sunyata000/AMY_MCU/README_AMY.md

# 项目赞助
<br>
小额赞助、购买FPGA开发板、提供开发支持、甚至是一条建议或者评论，都是鼓舞PODES前行的动力。如果您有意赞助，请使用手机支付扫一扫下面的二维码：<br>
       
<center>
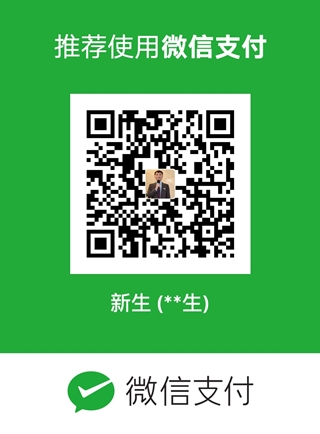
[picture p3: images/wechat.jpg]
    
    <div style="color:orange; border-bottom: 1px solid #d9d9d9;
    display: inline-block;
    color: #999;
    padding: 2px;">微信赞赏</div>
</center>
<br>
<center>
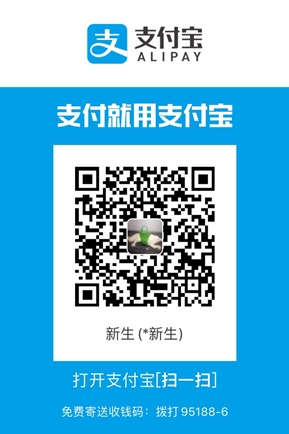
[picture p4: images/alipay.jpg]
    
    <div style="color:orange; border-bottom: 1px solid #d9d9d9;
    display: inline-block;
    color: #999;
    padding: 2px;">支付宝赞赏</div>
</center>
<br> 

[Back](https://github.com/sunyata000/AMY_MCU)
