sunyata000/AMY_MCU/sim/work/boot_test.txt

20000460
0000014D
00000155
00000157
00000000
00000000
00000000
00000000
00000000
00000000
00000000
00000159
00000000
00000000
0000015B
0000015D
0000015F
0000015F
0000015F
0000015F
0000015F
0000015F
0000015F
0000015F
0000015F
0000015F
0000015F
0000015F
0000015F
0000015F
0000015F
0000015F
0000015F
0000015F
0000015F
0000015F
0000015F
0000015F
0000015F
0000015F
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
46AB1E67
465D4654
D10142AC
F824F000
3E0F467E
46B6CC0F
42332601
1AFBD000
46AB46A2
47184333
000001C4
000001D4
24002300
26002500
D3013A10
D8FBC178
D3000752
D500C130
4770600B
46C0B51F
BD1F46C0
BD10B510
F89FF000
F7FF4611
F000FFF5
F000F844
B403F8B7
FFF2F7FF
F000BC03
0000F888
47804807
47004807
E7FEE7FE
E7FEE7FE
E7FEE7FE
49054804
4B064A05
00004770
00000265
000000C1
20000060
20000460
20000260
20000260
2101BF00
68490789
40112204
D0F80889
4917BF00
BF006008
4915BF00
22066849
29064011
4770D1F9
4603B500
7818E003
F7FF1C5B
7818FFE5
D1F82800
BF00BD00
490B2000
BF006048
2032BF00
BF0060C8
2003BF00
BF006088
2000BF00
BF006048
F7FFA004
207EFFE1
FFCAF7FF
E7FEBF00
40000000
594D415B
4F4F4220
203A5D54
2055434D
69207369
6F62206E
6D20746F
2E65646F
61655220
74207964
6572206F
76696563
68742065
6F632065
0A216564
00000000
4604B570
B2E5460E
F7FF4628
BD70FF9F
48054601
B5104770
B2E04604
FF96F7FF
BF00BD10
0000E7FE
FFFFFFFF
47704770
47704770
46754770
F822F000
000546AE
46534669
00C008C0
B0184685
F7FFB520
BC60FF6B
08492700
260046B6
C5C0C5C0
C5C0C5C0
C5C0C5C0
C5C0C5C0
00493D40
4770468D
46C04604
462046C0
FF43F7FF
47704800
20000000
00000300
20000000
00000460
00000104
00000000
00000000
00000000
00000000
00000000
00000000
00000000
00000000
00000000
00000000
00000000
FFFFFFFF
