sunyata000/AMY_MCU/sim/testcase/alu_test/alu_test.txt

200006C0
00000209
00000211
00000213
00000000
00000000
00000000
00000000
00000000
00000000
00000000
00000215
00000000
00000000
00000217
00000219
0000021B
0000021B
0000021B
0000021B
0000021B
0000021B
0000021B
0000021B
0000021B
0000021B
0000021B
0000021B
0000021B
0000021B
0000021B
0000021B
0000021B
0000021B
0000021B
0000021B
0000021B
0000021B
0000021B
0000021B
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
F83AF000
C830A00C
18243808
46A2182D
46AB1E67
465D4654
D10142AC
F82CF000
3E0F467E
46B6CC0F
42332601
1AFBD000
46AB46A2
47184333
00000970
00000990
24002300
26002500
D3013A10
D8FBC178
D3000752
D500C130
4770600B
2978B510
F000D102
BD10FAEF
BD102000
46C0B51F
BD1F46C0
BD10B510
FC2CF000
F7FF4611
F000FFF5
F000F8E5
B403FC44
FFF2F7FF
F000BC03
0000F812
4604B570
B2E5460E
F0004628
BD70F82B
48054601
B5104770
B2E04604
F822F000
BF00BD10
0000E7FE
FFFFFFFF
4604B570
26002503
481A00E1
FAEEF000
BF001E46
49182000
BF006088
6048BF00
BF00BF00
60C64608
2004BF00
BF004305
60854811
BD70BF00
490FBF00
22046849
08894011
BF00D0F9
6008490B
BF00BF00
68494909
40112206
D1F92906
B5004770
E0034603
1C5B7818
FFE6F7FF
28007818
BD00D1F8
02FAF080
40000000
00004770
47804807
47004807
E7FEE7FE
E7FEE7FE
E7FEE7FE
49054804
4B064A05
00004770
00000205
000000C1
200002C0
200006C0
200004C0
200004C0
00004770
4905B40F
AA03B510
F0009802
BC10F841
B004BC08
00004718
20000258
4604B5F8
2000460E
68E1E02D
47884620
D02A2800
D0022825
68A16862
68E1E020
27004620
00054788
4628D01F
28193841
2701D802
352002FF
46204632
46296027
FF3EF7FF
D0082800
D0042801
08F61DF6
360800F6
1D36E7D9
6862E7D7
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
30290C06
6930FA5A
69786960
6A849914
6C2910FF
3C294829
54297869
416C1209
28290829
78690129
78320981
69786941
38075A70
1A64F75A
F8DA08FC
2908290C
14085A10
18294429
3C290429
40290829
C40B5A41
2F5A0532
2317320C
A71A3039
3612320D
FFFF076C
4DC61A4D
591A1829
40EE1A91
B31A1829
AD3A1A08
414B9132
841A54E8
D02F3C20
FA230CFE
811104F6
68296E49
2941E469
29F06998
5554CD18
2B0C5555
05FC700F
02492410
00000010
