sunyata000/AMY_MCU/sim/testcase/div_test/div_test.txt

20000468
00000291
00000299
0000029B
00000000
00000000
00000000
00000000
00000000
00000000
00000000
0000029D
00000000
00000000
0000029F
000002A1
000002A3
000002A3
000002A3
000002A3
000002A3
000002A3
000002A3
000002A3
000002A3
000002A3
000002A3
000002A3
000002A3
000002A3
000002A3
000002A3
000002A3
000002A3
000002A3
000002A3
000002A3
000002A3
000002A3
000002A3
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
F84DF000
C830A00C
18243808
46A2182D
46AB1E67
465D4654
D10142AC
F83FF000
3E0F467E
46B6CC0F
42332601
1AFBD000
46AB46A2
47184333
00000630
00000650
D3023A10
C178C878
0752D8FA
C830D301
D501C130
600C6804
00004770
24002300
26002500
D3013A10
D8FBC178
D3000752
D500C130
4770600B
2964B510
F000D102
BD10F915
D1022978
F946F000
2000BD10
B51FBD10
46C046C0
B510BD1F
F000BD10
4611FAAB
FFF5F7FF
F808F000
F8BDF000
F7FFB403
BC03FFF2
F881F000
4C10B51C
4F102604
90012000
46304639
F95AF000
A00D9001
F0009901
00E1F897
F000480D
1F40F951
9000210A
F94CF000
46294605
F000A009
207EF889
F82EF000
E7FEBF00
0001C200
FFFFFFFD
203D206E
0A2E6425
00000000
1DCD6500
0A2E7825
00000000
4604B570
26002503
481A00E1
F92AF000
BF001E46
49182000
BF006088
6048BF00
BF00BF00
60C64608
2004BF00
BF004305
60854811
BD70BF00
490FBF00
22046849
08894011
BF00D0F9
6008490B
BF00BF00
68494909
40112206
D1F92906
B5004770
E0034603
1C5B7818
FFE6F7FF
28007818
BD00D1F8
02FAF080
40000000
4604B570
B2E5460E
F7FF4628
BD70FFD7
48054601
B5104770
B2E04604
FFCEF7FF
BF00BD10
0000E7FE
FFFFFFFF
00004770
47804807
47004807
E7FEE7FE
E7FEE7FE
E7FEE7FE
49054804
4B064A05
00004770
0000028D
000000C1
20000068
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
468500C0
B520B018
FDE6F7FF
2700BC60
46B60849
C5C02600
C5C0C5C0
C5C0C5C0
C5C0C5C0
3D40C5C0
468D0049
00004770
47704800
20000004
33323130
37363534
42413938
46454443
00583040
33323130
37363534
62613938
66656463
00783040
0000074C
20000000
00000004
00000104
00000750
20000004
00000464
00000120
00000000
