sunyata000/AMY_MCU/sim/testcase/gpio_test/gpio_test.txt

20000478
00000169
00000171
00000173
00000000
00000000
00000000
00000000
00000000
00000000
00000000
00000175
00000000
00000000
00000177
00000179
0000017B
0000017B
0000017B
0000017B
0000017B
0000017B
0000017B
0000017B
0000017B
0000017B
0000017B
0000017B
0000017B
0000017B
0000017B
0000017B
0000017B
0000017B
0000017B
0000017B
0000017B
0000017B
0000017B
0000017B
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
46AB1E67
465D4654
D10142AC
F832F000
3E0F467E
46B6CC0F
42332601
1AFBD000
46AB46A2
47184333
0000048C
000004AC
D3023A10
C178C878
0752D8FA
C830D301
D501C130
600C6804
00004770
24002300
26002500
D3013A10
D8FBC178
D3000752
D500C130
4770600B
46C0B51F
BD1F46C0
BD10B510
F9E4F000
F7FF4611
F000FFF5
F000F8D5
B403FA0D
FFF2F7FF
F000BC03
0000F82E
47804807
47004807
E7FEE7FE
E7FEE7FE
E7FEE7FE
49054804
4B064A05
00004770
000001CD
000000C1
20000078
20000478
20000278
20000278
4604B570
B2E5460E
F0004628
BD70F85B
48054601
B5104770
B2E04604
F852F000
BF00BD10
0000E7FE
FFFFFFFF
00004770
21012004
4A124081
BF006011
49112000
47706048
4A0F2100
23016952
421A408B
2201D001
2200E000
BF004610
D00E2800
68094909
4A081C49
21006011
69524A05
408B2301
4B03431A
BF00615A
4770BF00
E000E100
40000400
20000004
4604B570
26002503
481A00E1
F8B0F000
BF001E46
49182000
BF006088
6048BF00
BF00BF00
60C64608
2004BF00
BF004305
60854811
BD70BF00
490FBF00
22046849
08894011
BF00D0F9
6008490B
BF00BF00
68494909
40112206
D1F92906
B5004770
E0034603
1C5B7818
FFE6F7FF
28007818
BD00D1F8
02FAF080
40000000
00004770
4905B40F
AA03B510
F0009802
BC10F80B
B004BC08
00004718
20000000
47704770
00004770
B5704B08
447B460C
F909F000
46204605
FF66F7FF
D0022800
43C02000
4628BD70
0000BD70
FFFFFEC7
00000000
FFFFFFFF
024020E1
FF92F7FF
FF62F7FF
F7FFA018
A01BFFCD
FFCAF7FF
46012001
D1072901
68524A18
40832301
4B16431A
E006605A
68534A14
40822201
4A124393
BF006053
E00E2400
490F2001
22016809
40514082
60114A0C
2500BF00
1C6DE000
DBFC2D64
2C141C64
207EDBEE
FF7CF7FF
E7FEBF00
72617453
50472074
74204F49
2E747365
0000000A
40000400
09032200
D32C428B
428B0A03
2300D311
E04E469C
430B4603
2200D43C
428B0843
0903D331
D31C428B
428B0A03
4694D301
09C3E03F
D301428B
1AC001CB
09834152
D301428B
1AC0018B
09434152
D301428B
1AC0014B
09034152
D301428B
1AC0010B
08C34152
D301428B
1AC000CB
08834152
D301428B
1AC0008B
08434152
D301428B
1AC0004B
1A414152
4601D200
46104152
E05D4770
D0000FCA
10034249
4240D300
22004053
0903469C
D32D428B
428B0A03
22FCD312
BA120189
428B0A03
0189D30C
428B1192
0189D308
428B1192
0189D304
1192D03A
0989E000
428B09C3
01CBD301
41521AC0
428B0983
018BD301
41521AC0
428B0943
014BD301
41521AC0
428B0903
010BD301
41521AC0
428B08C3
00CBD301
41521AC0
428B0883
008BD301
41521AC0
0843D2D9
D301428B
1AC0004B
1A414152
4601D200
41524663
4610105B
4240D301
D5002B00
47704249
105B4663
4240D300
2000B501
46C046C0
0000BD02
1C4A6901
78086102
B5004770
9102B08F
91052100
93014905
91034479
90044611
F0004668
B00FF824
0000BD00
FFFFFFE5
F0004675
46AEF833
46690005
08C04653
468500C0
B520B018
FE26F7FF
2700BC60
46B60849
C5C02600
C5C0C5C0
C5C0C5C0
C5C0C5C0
3D40C5C0
468D0049
B5F84770
24004606
68806847
68F59000
9900E002
1C6447B8
47A84630
D1F82800
BDF84620
46C04604
462046C0
FDEDF7FF
47704800
20000014
000005A8
20000000
00000014
00000104
000005BC
20000014
00000464
00000120
00000000
00000000
00000000
00000000
00000000
