sunyata000/AMY_MCU/sim/testcase/hello_test/hello_test.txt

20000468
000001C5
000001CD
000001CF
00000000
00000000
00000000
00000000
00000000
00000000
00000000
000001D1
00000000
00000000
000001D3
000001D5
000001D7
000001D7
000001D7
000001D7
000001D7
000001D7
000001D7
000001D7
000001D7
000001D7
000001D7
000001D7
000001D7
000001D7
000001D7
000001D7
000001D7
000001D7
000001D7
000001D7
000001D7
000001D7
000001D7
000001D7
000001D7
000001D7
000001D7
000001D7
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
F86EF000
C830A00C
18243808
46A2182D
46AB1E67
465D4654
D10142AC
F860F000
3E0F467E
46B6CC0F
42332601
1AFBD000
46AB46A2
47184333
00001890
000018B0
D3023A10
C178C878
0752D8FA
C830D301
D501C130
600C6804
00004770
24002300
26002500
D3013A10
D8FBC178
D3000752
D500C130
4770600B
2970B510
F000D102
BD10FB1C
D1022966
FBB8F001
2965BD10
F001D102
BD10FBB3
D1022964
FAA2F000
2978BD10
F000D102
BD10FAFB
D1022963
FF6EF000
2973BD10
F000D102
BD10FF71
BD102000
46C0B51F
F00046C0
0004FF95
21002000
FB7CF001
BD1F60E0
BD10B510
FADCF001
F7FF4611
F000FFED
F001F8A7
B403FAF4
FFF2F7FF
F000BC03
0000F82E
47804807
47004807
E7FEE7FE
E7FEE7FE
E7FEE7FE
49054804
4B064A05
00004770
00000229
000000C1
20000068
20000468
20000268
20000268
4604B570
B2E5460E
F0004628
BD70F82D
48054601
B5104770
B2E04604
F824F000
BF00BD10
0000E7FE
FFFFFFFF
00004770
4604B570
26002503
481A00E1
FB66F000
BF001E46
49182000
BF006088
6048BF00
BF00BF00
60C64608
2004BF00
BF004305
60854811
BD70BF00
490FBF00
22046849
08894011
BF00D0F9
6008490B
BF00BF00
68494909
40112206
D1F92906
B5004770
E0034603
1C5B7818
FFE6F7FF
28007818
BD00D1F8
02FAF080
40000000
00004770
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
AA51823E
34A7EEDF
00000001
000042D9
E2A0B5DC
971F303A
FFFFFFFF
000045B4
C8A025FD
4FC1A3E9
FFFFFFFF
00003FFF
80000000
00000000
00003FFF
80000000
00000000
000019C8
20000000
00000004
00000104
000019CC
20000004
00000464
00000120
0000001C
00000043
FFFFFFF8
0000000C
0000000E
0000000F
0000002E
00000000
