sunyata000/AMY_MCU/sim/testcase/logic_test/logic_test.txt

20000468
00000179
00000181
00000183
00000000
00000000
00000000
00000000
00000000
00000000
00000000
00000185
00000000
00000000
00000187
00000189
0000018B
0000018B
0000018B
0000018B
0000018B
0000018B
0000018B
0000018B
0000018B
0000018B
0000018B
0000018B
0000018B
0000018B
0000018B
0000018B
0000018B
0000018B
0000018B
0000018B
0000018B
0000018B
0000018B
0000018B
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
46AB1E67
465D4654
D10142AC
F83AF000
3E0F467E
46B6CC0F
42332601
1AFBD000
46AB46A2
47184333
0000071C
0000073C
D3023A10
C178C878
0752D8FA
C830D301
D501C130
600C6804
00004770
24002300
26002500
D3013A10
D8FBC178
D3000752
D500C130
4770600B
2978B510
F000D102
BD10F9D5
BD102000
46C0B51F
BD1F46C0
BD10B510
FB26F000
F7FF4611
F000FFF5
F000F8CD
B403F8C3
FFF2F7FF
F000BC03
0000F82E
47804807
47004807
E7FEE7FE
E7FEE7FE
E7FEE7FE
49054804
4B064A05
00004770
000001DD
000000C1
20000068
20000468
20000268
20000268
4604B570
B2E5460E
F0004628
BD70F82D
48054601
B5104770
B2E04604
F824F000
BF00BD10
0000E7FE
FFFFFFFF
00004770
4604B570
26002503
481A00E1
F9B6F000
BF001E46
49182000
BF006088
6048BF00
BF00BF00
60C64608
2004BF00
BF004305
60854811
BD70BF00
490FBF00
22046849
08894011
BF00D0F9
6008490B
BF00BF00
68494909
40112206
D1F92906
B5004770
E0034603
1C5B7818
FFE6F7FF
28007818
BD00D1F8
02FAF080
40000000
00004770
4905B40F
AA03B510
F0009802
BC10FA71
B004BC08
00004718
20000000
4604B5F8
2000460E
68E1E02D
47884620
D02A2800
D0022825
68A16862
68E1E020
27004620
00054788
4628D01F
28193841
2701D802
352002FF
46204632
46296027
FF3EF7FF
D0082800
D0042801
08F61DF6
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
468500C0
B520B018
FCE4F7FF
2700BC60
46B60849
C5C02600
C5C0C5C0
C5C0C5C0
C5C0C5C0
3D40C5C0
468D0049
00004770
47704800
20000004
33323130
37363534
42413938
46454443
00583040
33323130
37363534
62613938
66656463
00783040
00000838
20000000
00000004
00000104
0000083C
20000004
00000464
00000120
00000000
