sunyata000/AMY_MCU/sim/testcase/ucos_test/ucos_test.txt

200007E8
000001D5
000001DD
000001DF
00000000
00000000
00000000
00000000
00000000
00000000
00000000
000001E1
00000000
00000000
000001E3
000001F1
000001E7
000001E7
000001E7
000001E7
000001E7
000001E7
000001E7
000001E7
000001E7
000001E7
000001E7
000001E7
000001E7
000001E7
000001E7
000001E7
000001E7
000001E7
000001E7
000001E7
000001E7
000001E7
000001E7
000001E7
000001E7
000001E7
000001E7
000001E7
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
FDFAF000
47004800
0000017F
200007E8
F000B510
4815F893
22016841
60414311
B510BD10
F872F000
FFF2F7FF
024020E1
F89EF000
F000480E
BD10F801
B510490D
D9014288
BD102001
0A090201
1E49480A
490A6141
69CB2207
0A1B021B
43230404
210061CB
61026181
BD104608
40000400
00075300
00FFFFFF
E000E000
E000ED04
F89EF000
F000A018
2200F88E
461123C8
F0004610
E7F5FD35
F892F000
68684D16
43202401
68286068
60284060
23C82200
46104611
FD24F000
B510E7F5
F882F000
FFAFF7FF
F9CEF000
4A0C2301
480C2100
FB2EF000
4A0B2302
480B2100
FB28F000
FA35F000
BD102000
4F2F4375
45542053
0A215453
00000000
40000400
20000128
0000015D
20000228
00000145
00004770
47804804
47004804
E7FEE7FE
E7FEE7FE
E7FEE7FE
000001D1
000000C1
F000B510
F000F9DD
F000FA1E
BD10F9E3
20104909
49096008
60482000
48074770
22016941
D0064011
680B4905
600B1C5B
43116941
47706141
E000E100
40000400
20000000
00C1B510
F0004811
1E40F83D
21012200
608A0789
60C8604A
60882007
2101BD10
684A0789
D5FC0752
68486008
0F800740
D1FA2803
B5004770
E0024603
F7FF1C5B
7818FFEE
D1F92800
0000BD00
02FAF080
4770B662
4770B672
460BB530
20004601
24012220
460DE009
429D40D5
461DD305
1B494095
40954625
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
00020001
00030001
00020001
00050001
00020001
00030001
00020001
00040001
00020001
00030001
00020001
00070001
00020001
00030001
00020001
00040001
00020001
00030001
00020001
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
000007BC
00000CE0
00000000
00000000
00000000
00000000
00000000
00000000
00000000
00000000
00000000
00000000
00000000
