sunyata000/AMY_MCU/src/PODES_M0O/log_shft.v

//************************************************************************//
//PODES:    Processor Optimization for Deeply Embedded System                                                                 
//Web:      http://www.mcucore.org                        
//Bug report: sunyata.peng@foxmail.com                                                                          
//Q_Q:   2143971503         
//************************************************************************//
//                                                                          
//  PODES_M0O - PODES IP Core                              
//                                      
//                                                                          
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
//  Full details of the license can be found in the file LGPL.TXT.          
//                                                                          
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
//************************************************************************//
// File        : log_shft.v
// Author      : PODES
// Date        : 20200101
// Version     : 1.0
// Description : Logic shifter. 
// -----------------------------History-----------------------------------//
// Date      BY   Version  Change Description
//
// 20200101  PODES   1.0      Initial Release. 
//                                                                        
//************************************************************************//
// --- CVS information:
// ---    $Author: $
// ---    $Revision: $
// ---    $Id: $
// ---    $Log$ 
//
//************************************************************************//

module log_shft (
                 optype,
                 opand1,
                 opand2,
                 result,
                 cin ,
                 cout
                 ) ;

//-----------------------------------------------------------//
//                      INPUTS / OUTPUTS                     //
//-----------------------------------------------------------//
input [4:0]       optype;
input [31:0]      opand1;
input [31:0]      opand2;
input             cin;
             
output [31:0]     result;
output             cout;

//-----------------------------------------------------------//
//                    REGISTERS & WIRES                      //
//-----------------------------------------------------------//

wire [31:0]     result;
wire            cout;

reg [31:0]      tmp_result;
reg             tmp_cout;


//-----------------------------------------------------------//
//                          PARAMETERS                       //
//-----------------------------------------------------------//
//parameter INV_0  = 1'b0;

 parameter OP_IDLE  =  5'h00;
 parameter OP_BL    =  5'h01;
 parameter OP_MSR   =  5'h02;
 parameter OP_MRS   =  5'h03;
 parameter OP_LSL   =  5'h04;
 parameter OP_LSR   =  5'h05;
 parameter OP_ASR   =  5'h06;
 parameter OP_ADD   =  5'h07;
 parameter OP_OR    =  5'h08;
 parameter OP_AND   =  5'h09;
 parameter OP_XOR   =  5'h0a;
 parameter OP_RSR   =  5'h0b;
 parameter OP_MUL   =  5'h0c;
 parameter OP_MR    =  5'h0d;
 parameter OP_MW    =  5'h0e;
 parameter OP_CPS   =  5'h0f;
 parameter OP_PUSH  =  5'h10;
 parameter OP_POP   =  5'h11;
 parameter OP_BX    =  5'h12;
 parameter OP_BLX   =  5'h13;


//-----------------------------------------------------------//
//                          ARCHITECTURE                     //
//-----------------------------------------------------------//

//logic and shift operations
wire [7:0] shift_n = ((optype == OP_RSR) && (opand2[7:0] > 8'h20))? {3'b000, opand2[4:0]} : opand2[7:0];
//LSL
always @ *
begin
case (optype) 
      OP_OR:
          begin
            tmp_result = opand1 | opand2;
            tmp_cout   = cin;
          end
      
      OP_XOR:
          begin
            tmp_result = opand1 ^ opand2;
            tmp_cout   = cin;
          end
                  
      OP_AND:
          begin
            tmp_result = opand1 & opand2;
            tmp_cout   = cin;
          end
      
      OP_LSL,
      OP_LSR,
      OP_ASR,
      OP_RSR:
          begin      
            case (shift_n) 
                8'd0:
                    begin
                      tmp_result = opand1;
                      tmp_cout   = cin;
                    end
                8'd1:
                    begin
                      if (optype == OP_LSL)
                        begin
                          tmp_result = {opand1[30:0], 1'b0};
                          tmp_cout   = opand1[31];
                        end      
                      else
                        begin
                          tmp_cout = opand1[0];
                          tmp_result[30:0] = opand1[31:1];
                          tmp_result[31] = (optype == OP_LSR)? 1'b0 : ((optype == OP_ASR) ? opand1[31] : opand1[0]);
                        end                         
                    end
                8'd2:
                    begin
                      if (optype == OP_LSL)
                        begin
                          tmp_result = {opand1[29:0], 2'b0};
                          tmp_cout   = opand1[30];
                        end      
                      else
                        begin
                          tmp_cout = opand1[1];
                          tmp_result[29:0] = opand1[31:2];
                          tmp_result[31:30] = (optype == OP_LSR)? 2'b0 : ((optype == OP_ASR) ? {2{opand1[31]}} : opand1[1:0]);
                        end                         
                    end
                8'd3:
                    begin
                      if (optype == OP_LSL)
                        begin
                          tmp_result = {opand1[28:0], 3'b0};
                          tmp_cout   = opand1[29];
                        end      
                      else
                        begin
                          tmp_cout = opand1[2];
                          tmp_result[28:0] = opand1[31:3];
                          tmp_result[31:29] = (optype == OP_LSR)? 3'b0 : ((optype == OP_ASR) ? {3{opand1[31]}} : opand1[2:0]);
                        end                         
                    end
                8'd4:
                    begin
                      if (optype == OP_LSL)
                        begin
                          tmp_result = {opand1[27:0], 4'b0};
                          tmp_cout   = opand1[28];
                        end      
                      else
                        begin
                          tmp_cout = opand1[3];
                          tmp_result[27:0] = opand1[31:4];
                          tmp_result[31:28] = (optype == OP_LSR)? 4'b0 : ((optype == OP_ASR) ? {4{opand1[31]}} : opand1[3:0]);
                        end                         
                    end
                8'd5:
                    begin
                      if (optype == OP_LSL)
                        begin
                          tmp_result = {opand1[26:0], 5'b0};
                          tmp_cout   = opand1[27];
                        end      
                      else
                        begin
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
                          tmp_result[1:0] = opand1[31:30];
                          tmp_result[31:2] = (optype == OP_LSR)? 30'b0 : ((optype == OP_ASR) ? {30{opand1[31]}} : opand1[29:0]);
                        end                         
                    end
                8'd31:
                    begin
                      if (optype == OP_LSL)
                        begin
                          tmp_result = {opand1[0], 31'b0};
                          tmp_cout   = opand1[1];
                        end      
                      else
                        begin
                          tmp_cout = opand1[30];
                          tmp_result[0] = opand1[31];
                          tmp_result[31:1] = (optype == OP_LSR)? 31'b0 : ((optype == OP_ASR) ? {31{opand1[31]}} : opand1[30:0]);
                        end                         
                    end
                8'd32:
                    begin
                      if (optype == OP_LSL)
                        begin
                          tmp_result = 32'b0;
                          tmp_cout   = opand1[0];
                        end      
                      else
                        begin
                          tmp_cout = opand1[31];
                          tmp_result[31:0] = (optype == OP_LSR)? 32'b0 : ((optype == OP_ASR) ? {32{opand1[31]}} : opand1[31:0]);
                        end                         
                    end
                default:
                    begin
                      if ((optype == OP_LSL) | (optype == OP_LSR))
                        begin
                          tmp_result = 32'b0;
                          tmp_cout   = 1'b0;
                        end      
                      else
                        begin //????
                          tmp_cout = opand1[31];
                          tmp_result[31:0] = (optype == OP_ASR) ? {32{opand1[31]}} : opand1[31:0];
                        end                         
                    end
        endcase
      end
    default: 
        begin
          tmp_cout = cin;
          tmp_result = opand1;
        end 
endcase
end

assign result = tmp_result;
assign cout   = tmp_cout;

endmodule
